hotchk155/cvtv/hardware/cvtv.brd

## EAGLE design hardware/cvtv.brd (2025-04-09)

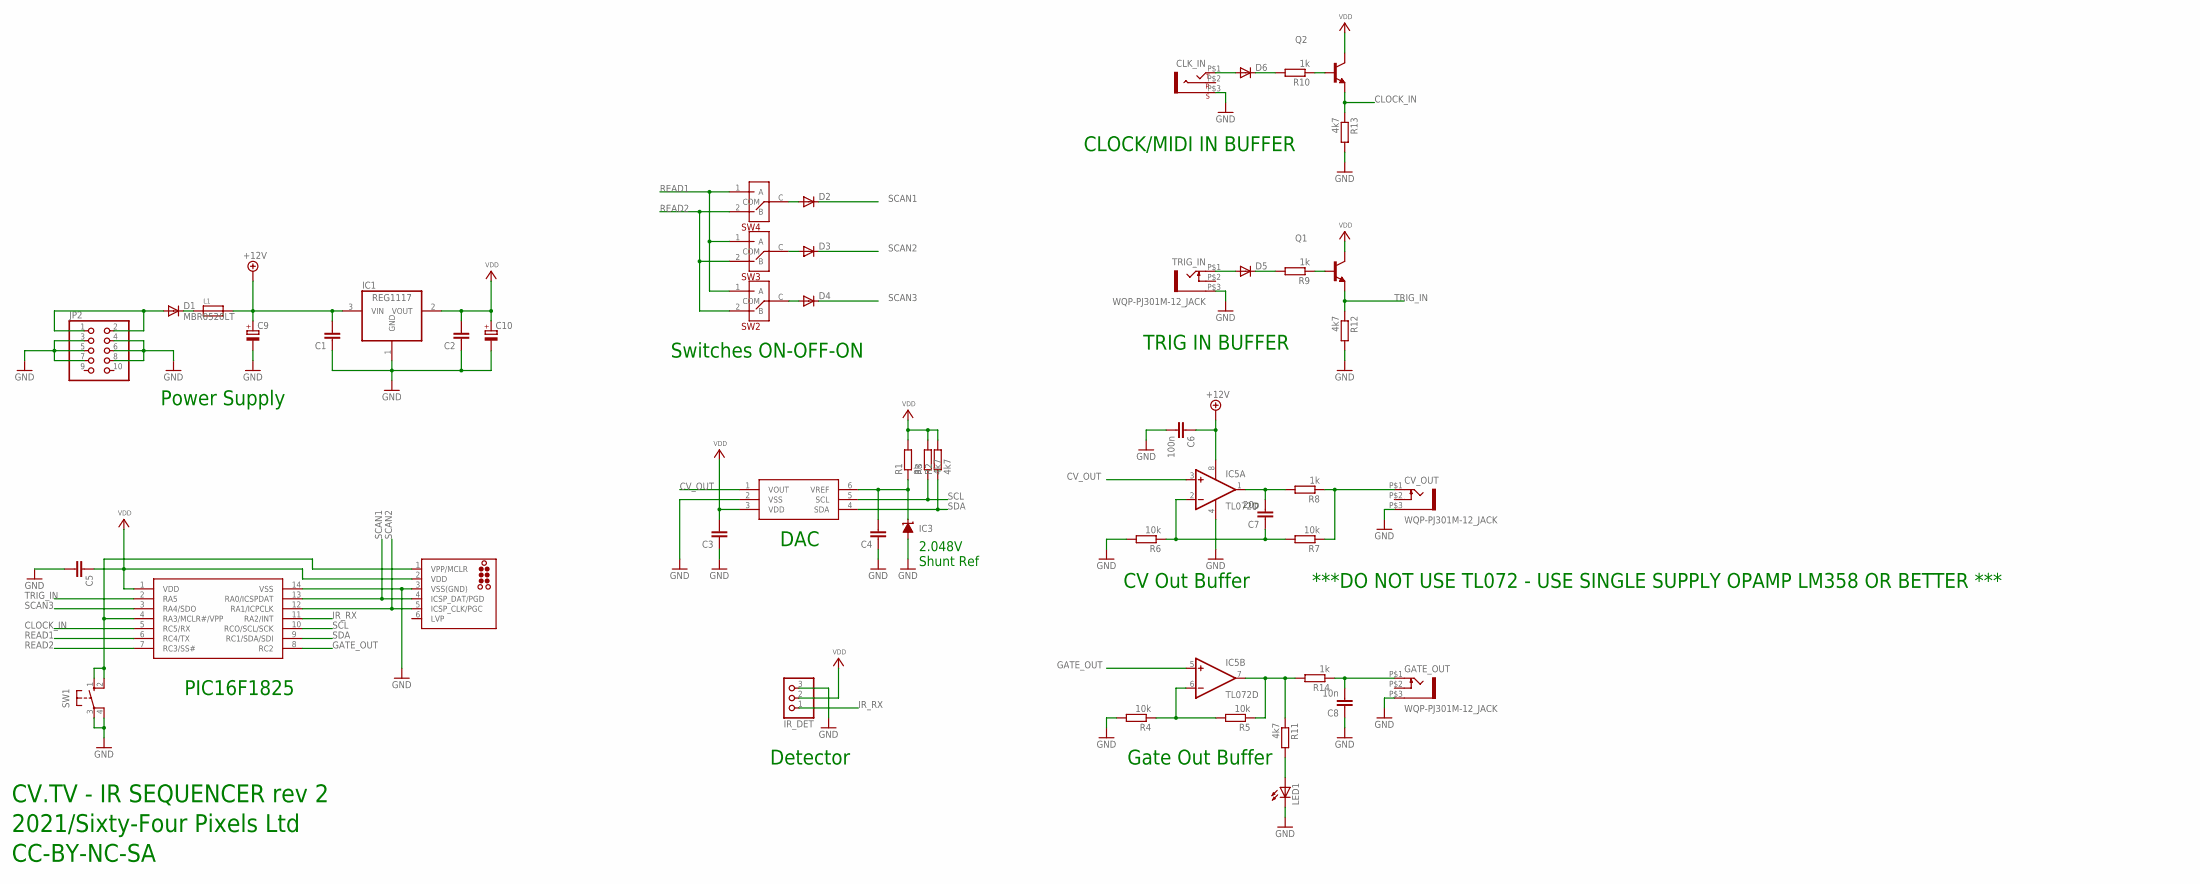
[picture p1: schematic cvtv.sch]

Parts:
C1, C2, C3, C4, C5: C-EUC0805; C0805
C6: 100n; C0805
C7: 20p; C0805
C8: 10n; C0805
C9, C10: CPOL-EUE2-5; E2-5
CLK_IN: THONKICONN_STEREO; WQP-PJ301M-ST
CV_OUT: WQP-PJ301M-12_JACK
D1: MBR0520LT; SOD123
D2, D3, D4, D5, D6: TS4148; D0805
GATE_OUT: WQP-PJ301M-12_JACK
IC1: REG1117; SOT223
IC2: PIC16F1825SO14; SO14
IC3: LM4041A12DBZ; DBZ_R-PDSO-G3
IC4: MCP4726; SOT23-6
IC5: TL072D; SO08
ICSP: TC2030-MCP-NL
IR_DET: PINHD-1X3; 1X03
JP2: PINHD-2X5; 2X05
L1: FERRITE; 0603
LED1: LED3MM
Q1, Q2: MMBT3904LT1-NPN-SOT23-BEC; SOT23-BEC
R1: 3k; R0805
R2, R3, R11, R12, R13: 4k7; R0805
R4, R5, R6, R7: 10k; R0805
R8, R9, R10, R14: 1k; R0805
SW1: 10-XX; B3F-10XX
SW2, SW3, SW4: MICRO-SPDT
TRIG_IN: WQP-PJ301M-12_JACK

Connections:
+12V: C1.2, C6.1, C9.+, IC1.3 (VIN), IC5.8 (V+), L1.2
CLOCK_IN: IC2.5 (RC5/RX), Q2.E, R13.1
CV_OUT: IC4.1 (VOUT), IC5.3 (+IN)
GATE_OUT: IC2.8 (RC2), IC5.5 (+IN)
GND: C1.1, C2.1, C3.1, C4.1, C5.2, C6.2, C8.1, C9.-, C10.-, CLK_IN.P$3 (S), CV_OUT.P$3 (1), GATE_OUT.P$3 (1), IC1.1 (GND), IC2.14 (VSS), IC3.2 (A), IC4.2 (VSS), IC5.4 (V-), ICSP.3 (VSS(GND)), IR_DET.3, JP2.3, JP2.4, JP2.5, JP2.6, JP2.7, JP2.8, LED1.K (C), R4.2, R6.2, R12.2, R13.2, SW1.3, SW1.4 (P1), TRIG_IN.P$3 (1)
IR_RX: IC2.11 (RA2/INT), IR_DET.1
unnamed: D1.A, JP2.1, JP2.2
unnamed: IC2.4 (RA3/MCLR#/VPP), ICSP.1 (VPP/MCLR), SW1.1 (S), SW1.2 (S1)
unnamed: CLK_IN.P$1 (T), D6.A
unnamed: D1.C, L1.1
unnamed: LED1.A, R11.2
unnamed: C4.2, IC3.1 (C), IC4.6 (VREF), R1.1
unnamed: D6.K (C), R10.2
unnamed: Q2.B, R10.1
unnamed: D5.A, TRIG_IN.P$1 (2)
unnamed: D2.A, SW4.C (COM)
unnamed: D5.K (C), R9.2
unnamed: IC5.7 (OUT), R5.1, R11.1, R14.2
unnamed: D3.A, SW3.C (COM)
unnamed: C8.2, GATE_OUT.P$1 (2), R14.1
unnamed: IC5.6 (-IN), R4.1, R5.2
unnamed: C7.1, IC5.2 (-IN), R6.1, R7.2
unnamed: CV_OUT.P$1 (2), R7.1, R8.1
unnamed: C7.2, IC5.1 (OUT), R8.2
unnamed: Q1.B, R9.1
unnamed: D4.A, SW2.C (COM)
READ1: IC2.6 (RC4/TX), SW2.1 (A), SW3.1 (A), SW4.1 (A)
READ2: IC2.7 (RC3/SS#), SW2.2 (B), SW3.2 (B), SW4.2 (B)
SCAN1: D2.K (C), IC2.13 (RA0/ICSPDAT), ICSP.4 (ICSP_DAT/PGD)
SCAN2: D3.K (C), IC2.12 (RA1/ICPCLK), ICSP.5 (ICSP_CLK/PGC)
SCAN3: D4.K (C), IC2.3 (RA4/SDO)
SCL: IC2.10 (RCO/SCL/SCK), IC4.5 (SCL), R3.1
SDA: IC2.9 (RC1/SDA/SDI), IC4.4 (SDA), R2.1
TRIG_IN: IC2.2 (RA5), Q1.E, R12.1
VDD: C2.2, C3.2, C5.1, C10.+, IC1.2 (VOUT), IC2.1 (VDD), IC4.3 (VDD), ICSP.2 (VDD), IR_DET.2, Q1.C, Q2.C, R1.2, R2.2, R3.2

Notes on the sheet:
DAC
2.048V Shunt Ref
Power Supply
Detector
PIC16F1825
Switches ON-OFF-ON
CV Out Buffer
Gate Out Buffer
CV.TV - IR SEQUENCER rev 2
2021/Sixty-Four Pixels Ltd
CC-BY-NC-SA
***DO NOT USE TL072 - USE SINGLE SUPPLY OPAMP LM358 OR BETTER ***
CLOCK/MIDI IN BUFFER
TRIG IN BUFFER

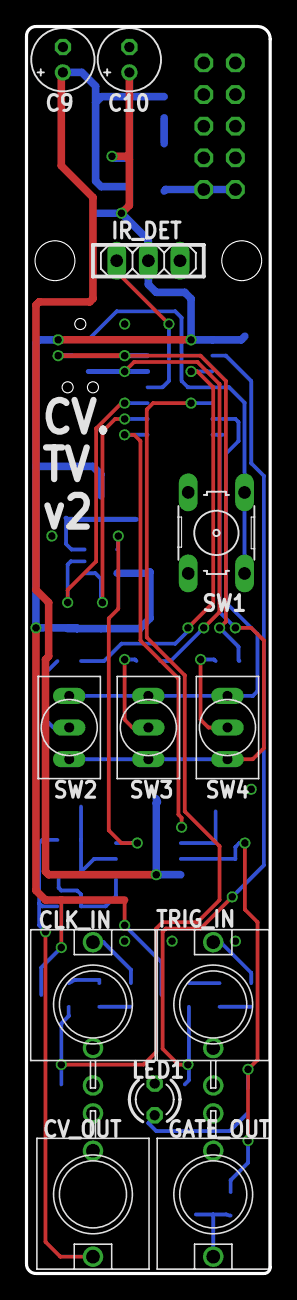
[picture p2: board cvtv.brd from above]

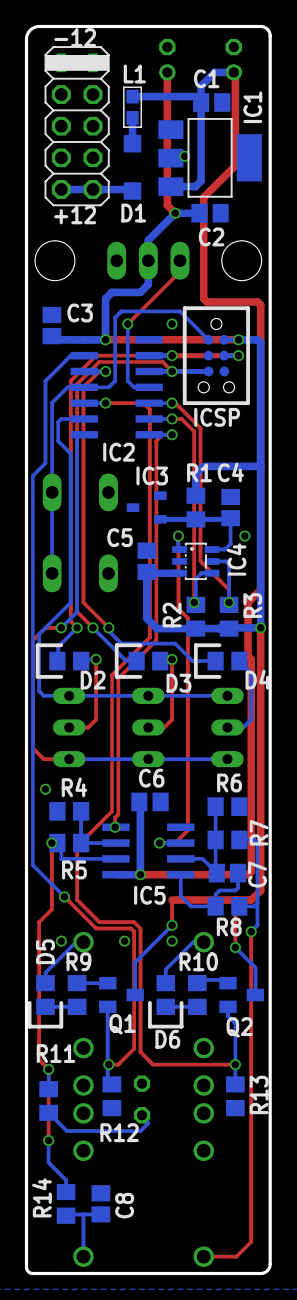
[picture p3: board cvtv.brd from below]

Board: 2 copper layers, 19.6 x 100.1 mm, 50 parts (38 on the bottom side), 35 nets.
