hotchk155/cvtv/(commit log)

2021-12-23 board updates
    [remote_control.brd, remote_control.sch]
2025-04-09 check in updates
    [cvtv.brd, cvtv.sch]
